carrier-labs/hardware-library/components/carrier/views/bench.scad

// A 6 x 6 bench plate, for the catalogue: 60 x 60 x 4, a tap hole on every grid point.
use <../carrier.scad>

bx = 6; by = 6;

benchPlate(bx, by);
