carrier-labs/hardware-library/components/esp32-s3-devkitc/views/carrier.scad

// The S3 on its carrier, for the catalogue: a 7 x 3 plate (solid), the pedestal frame between
// the pin rows, the back stop under the module's overhang, a snap hook either side of it over the
// board's back edge, and the wall lip across the USB end. YD clone, right-hand port, made for a
// 2.4 wall. The plastic only: the Ghost is % so it never renders.
use <../esp32-s3-devkitc.scad>

s3Carrier();
