carrier-labs/hardware-library/components/lipo-cradle/views/bar.scad

// The bridge's bar where it sits snapped into the carrier's posts, for the catalogue: the
// moving part of the "On a carrier" view, and the body for the collision check. It is a
// separate print: lipoBridgeBar() draws it flat for export.
use <../lipo-cradle.scad>

name = "602530";

lipoBridgeBarSeated(name);
