carrier-labs/hardware-library/components/lipo-cradle/views/carrier.scad

// The 602530's carrier for the catalogue: a 4 x 5 plate with the cradle on it and the
// bridge posts either side, as one piece of plastic. The bar is views/bar.scad; the pack
// is views/pack.scad (the cradle frame is the carrier frame).
use <../lipo-cradle.scad>

name = "602530";

lipoCarrier(name);
