carrier-labs/hardware-library/(list of files, cad)

Other CAD files:
components/snap-hook/views/board.scad
components/firebeetle-esp32e/views/screws.scad
components/usb-c-port/views/socket.scad
components/board-pocket/views/board.scad
components/board-pocket/views/station.scad
components/esp32-c3-supermini/views/board.scad
components/esp32-c3-supermini/views/station.scad
components/wago-221/views/carrier.scad
components/wago-221/views/screws.scad
components/wago-221/views/station.scad
components/wago-221/views/wago.scad
