carrier-labs/hardware-library/(commit log)

2026-11-04 Hardware library: printed holders and fit pieces for 13 bought parts, with a 3D catalogue
    screw-post, usb-c-port, board-pocket, firebeetle-esp32e, esp32-c3-supermini,
    esp32-s3-devkitc, rs485-max485, rj45-breakout, as5600-mount, wago-221,
    lipo-cradle, neopixel-strip, tactile-6x6. All at "measured": fit pieces not yet printed.
    [as5600-mount.scad, board-pocket.scad, board.scad, esp32-c3-supermini.scad, esp32-s3-devkitc.scad, firebeetle-esp32e.scad, fit.scad, jack.scad]
2026-11-04 feat(parts): parts and sources sheets; catalogue shows where to buy
    parts/parts.csv: one row per buyable thing with manufacturer and MPN;
    parts/sources.csv: one row per place to buy it. Seeded from what's in hand.
    [parts.csv, sources.csv]
2026-11-08 feat(carrier, snap-hook, bridge): the carrier system's base parts
    Every bought part sits on a carrier: a 1.6 plate in whole 10 mm grid units
    with M2.5 holes at its corners, self-tapped into bosses on a box floor or a
    bench plate. snap-hook clicks a holeless board onto it; bridge is a snap-on
    bar over anything that can't be hooked.
    [bar.scad, bench.scad, board.scad, bridge.scad, carrier.scad, fit.scad, floor.scad, pack.scad]
2026-11-08 feat(rs485-max485): carrier, 5 x 3, snap hooks over the long edges
    [board.scad, carrier.scad, rs485-max485.scad]
2026-11-08 feat(wago-221): carrier, sized per connector so the screw heads clear the clip
    [carrier.scad, screws.scad, wago-221.scad]
2026-11-08 feat(lipo-cradle): carrier with a bridge over the pack; size planner per cell code
    [bar.scad, carrier.scad, lipo-cradle.scad]
2026-11-08 feat(firebeetle-esp32e): carrier, 7 x 3, wall lip; USB end held by the socket pocket, M2 x 6 at the far end
    [carrier-board.scad, carrier-screws.scad, carrier.scad, firebeetle-esp32e.scad]
2026-11-08 feat(esp32-s3-devkitc): carrier, 7 x 3, two hooks at the antenna end, wall lip; header pins point down 7.7
    [carrier-board.scad, carrier.scad, esp32-s3-devkitc.scad]
2026-11-08 docs(carrier): sizes as built, screw-head keep-out rule; root table lists the system parts
